ffxx283/1999_Audio_Store_Playback/README.md

# 1999_Audio_Store_Playback
1999年电子设计竞赛，数字语音存储回放系统

演示视频：https://www.bilibili.com/video/BV1V4411g7uC/?vd_source=6558ddc0d154038071417e118132c386
