ffxx283/1999_Audio_Store_Playback/Doc/题目+评分表.pdf

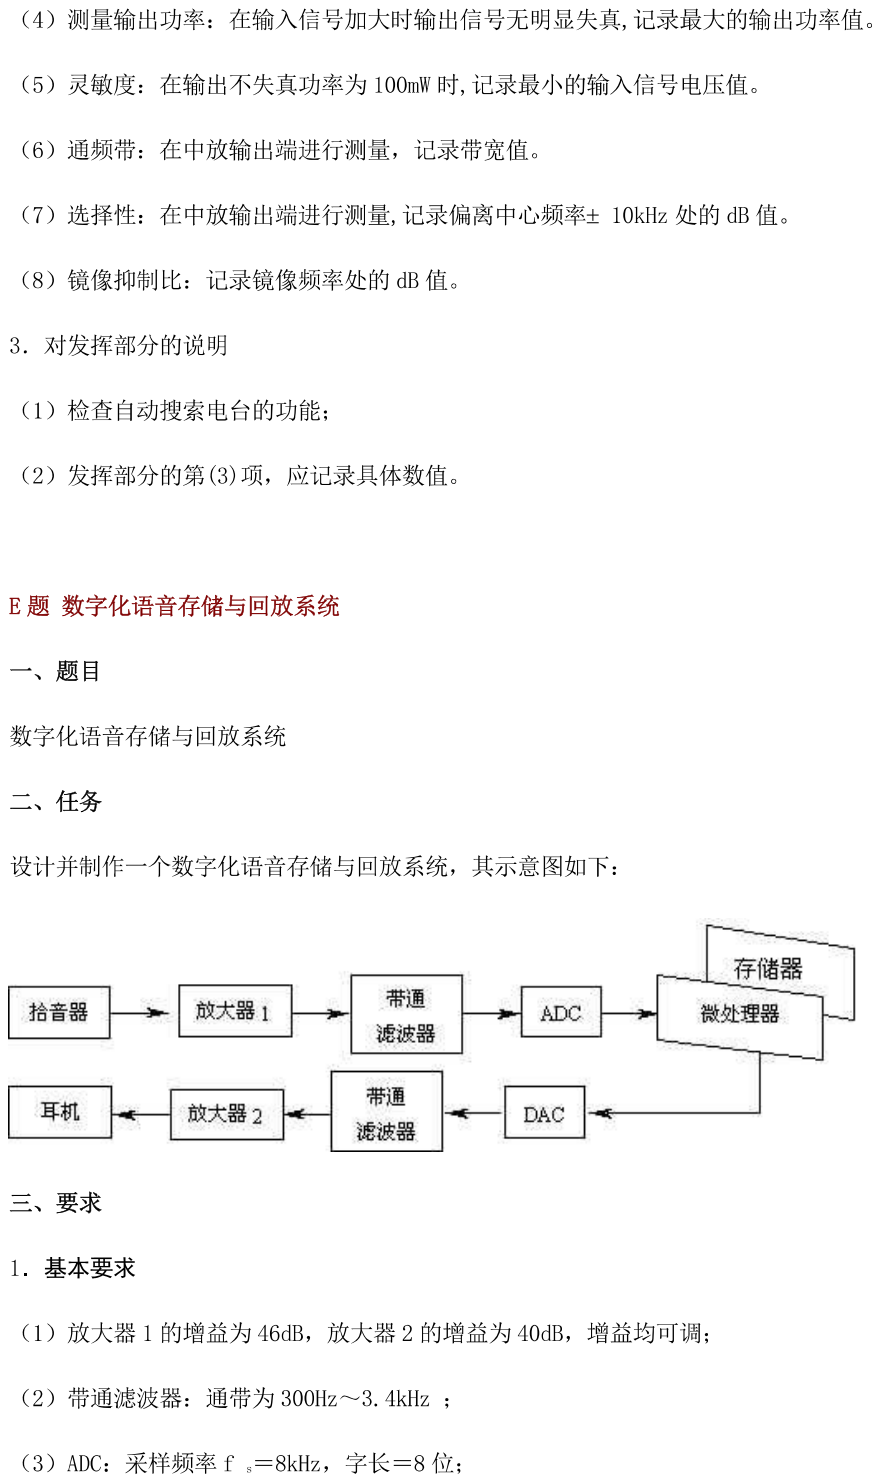
[picture p8: page 1]

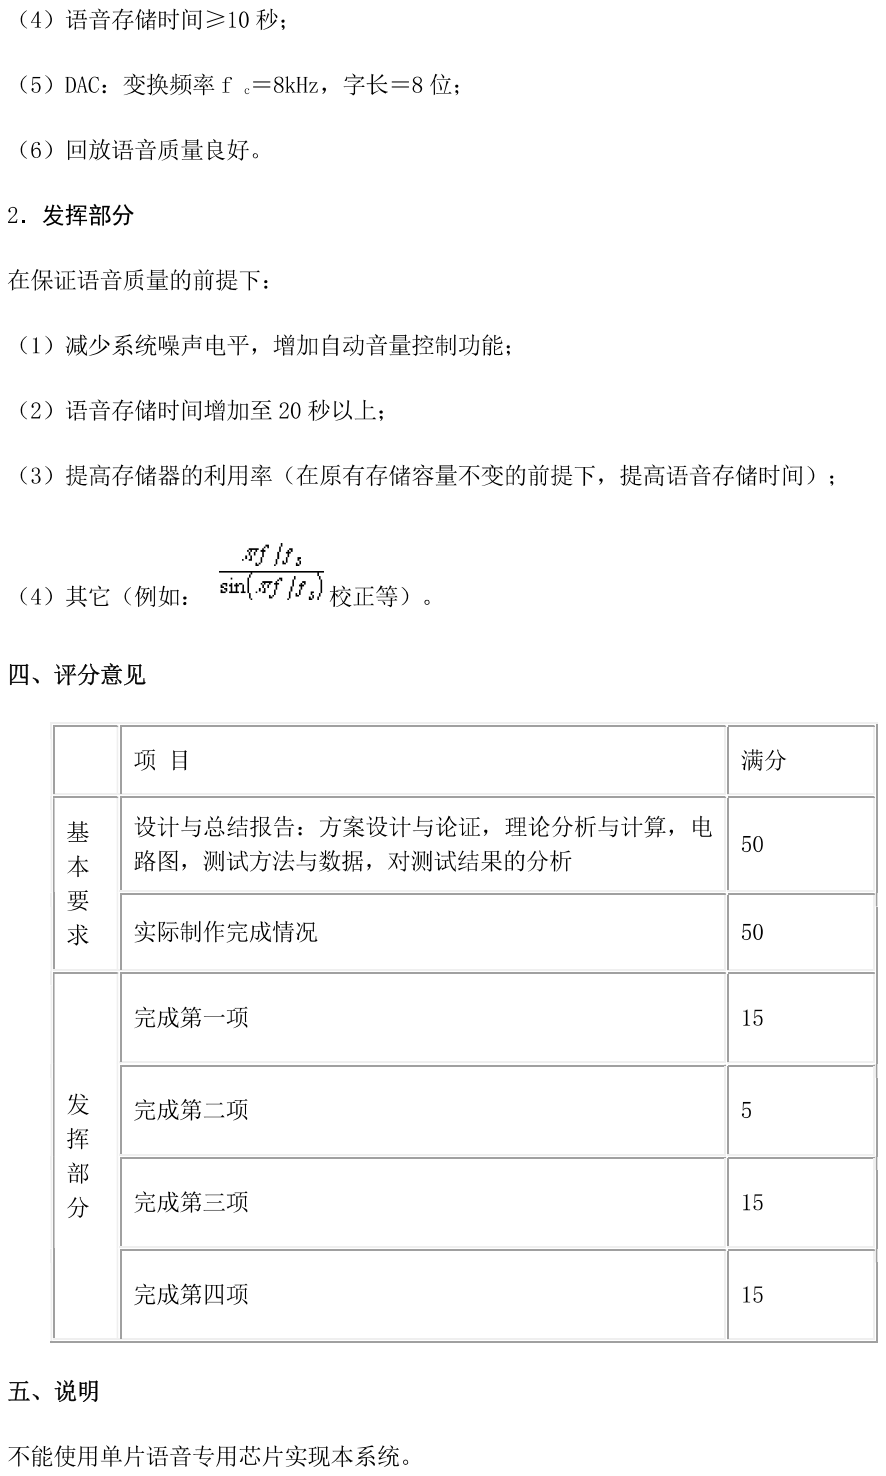
[picture p9: page 2]

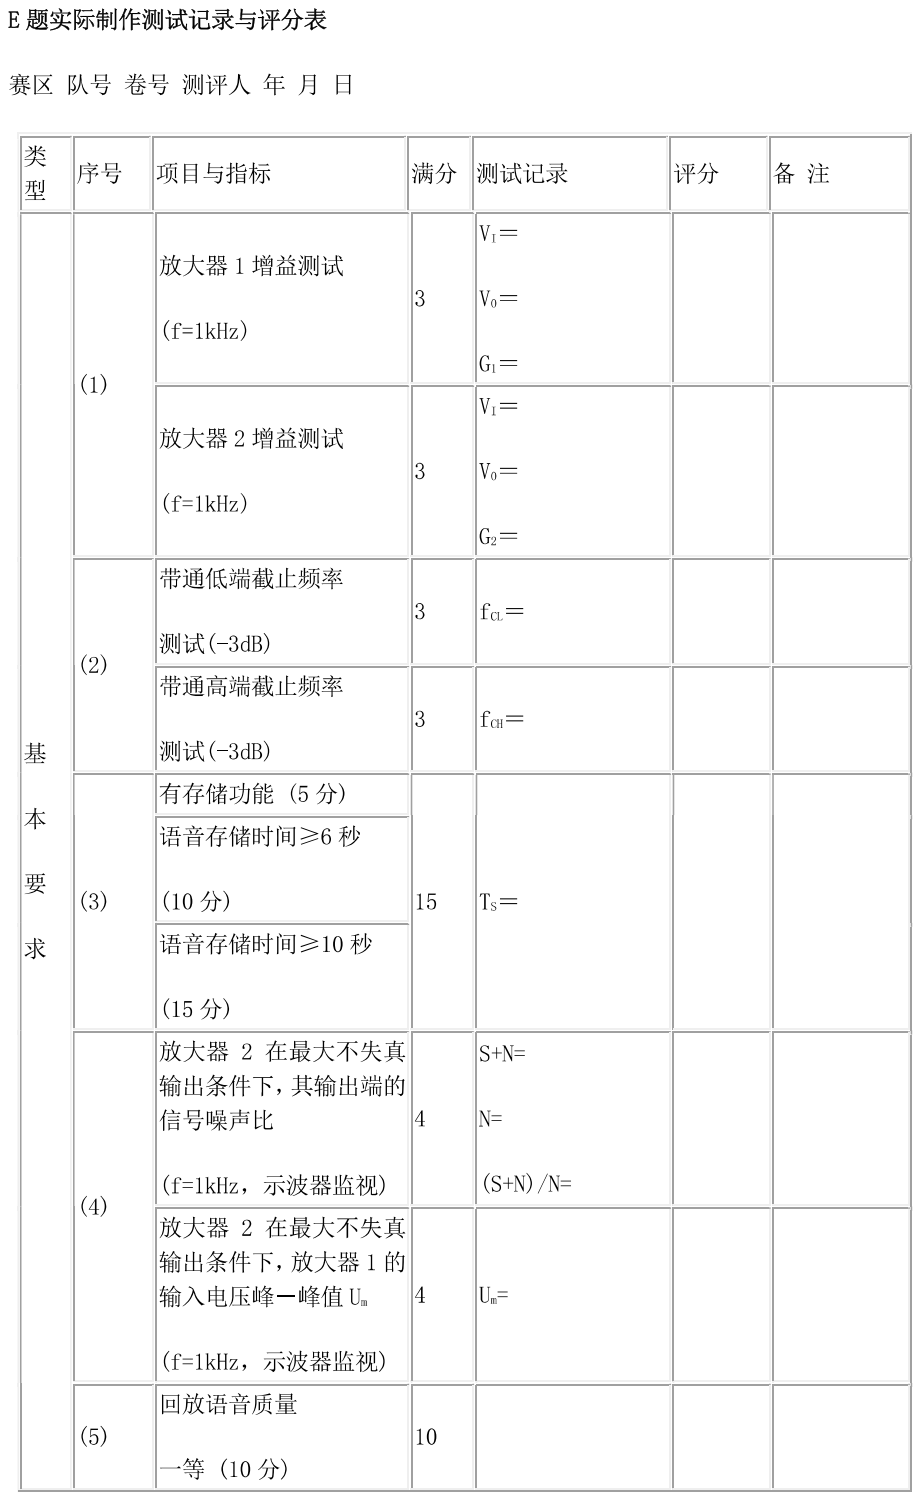
[picture p10: page 3]

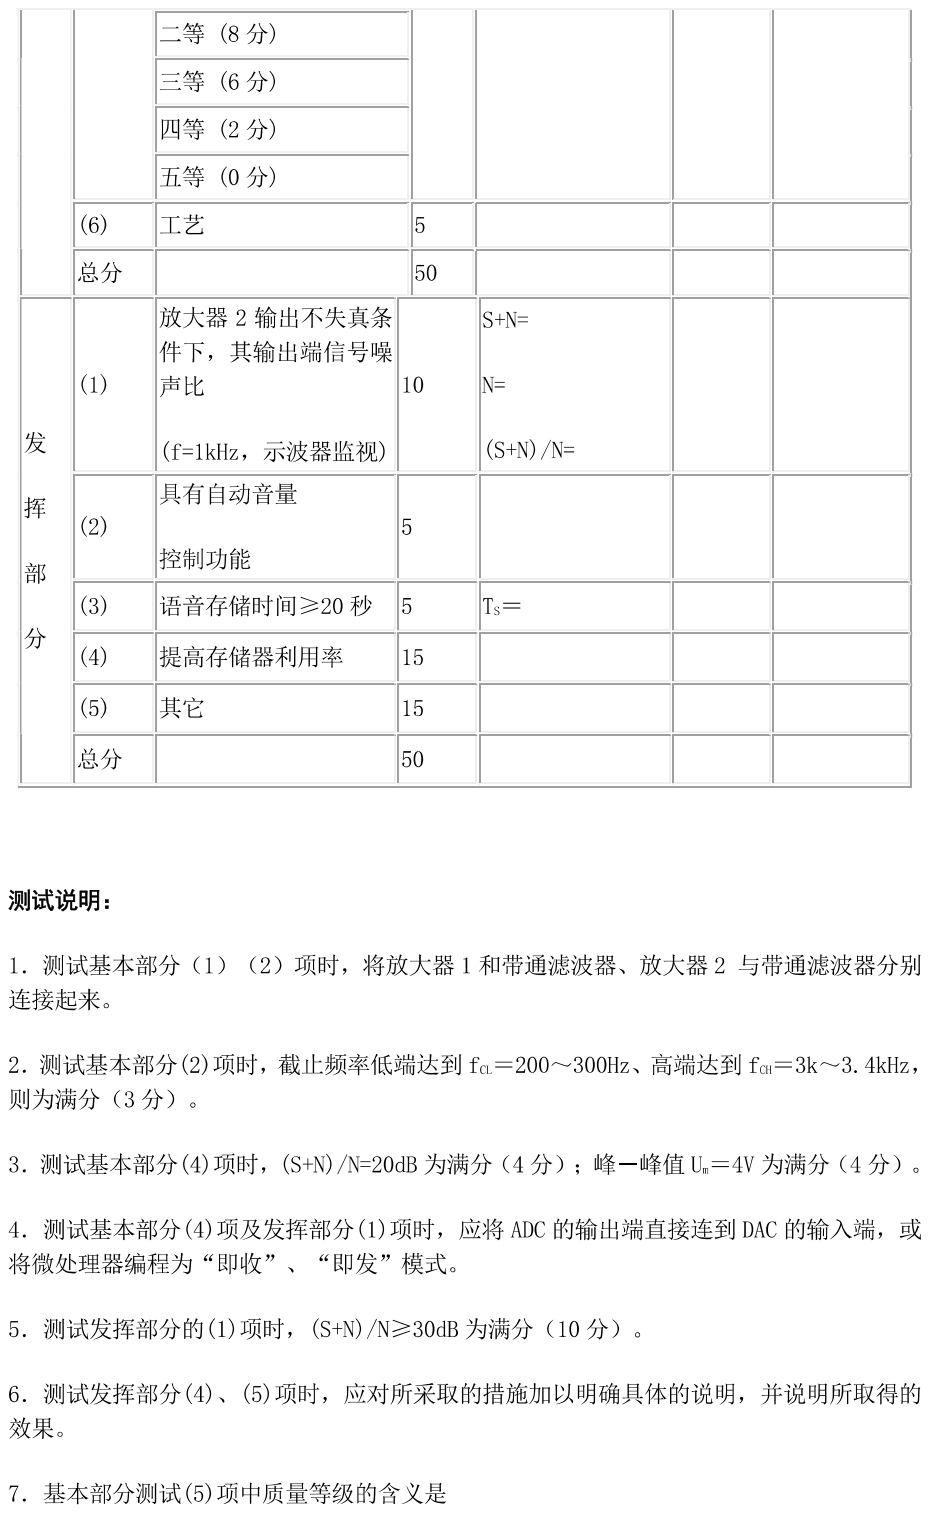
[picture p11: page 4]

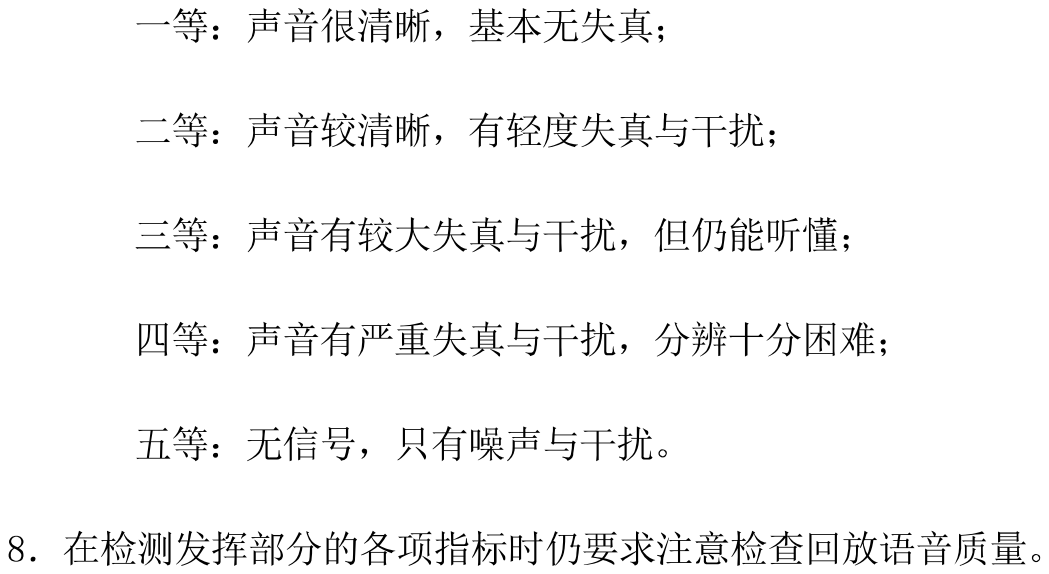
[picture p12: page 5]
