ffxx283/1999_Audio_Store_Playback/(list of files, drawings)

Other design files:
Hardware/00 电路模板/电路1.ms13
Hardware/01 电压偏置电路/电路1.ms13
Hardware/03 一比一电压跟随器/电路1.ms13
Hardware/04 限幅电路/电路1.ms13
Hardware/05 频率比较器/电路1.ms13
Hardware/50HZ滤波器设计/仿真/电路1.ms13
